e0r/HVDP_GXJ/IMG_20220321_161250.jpg

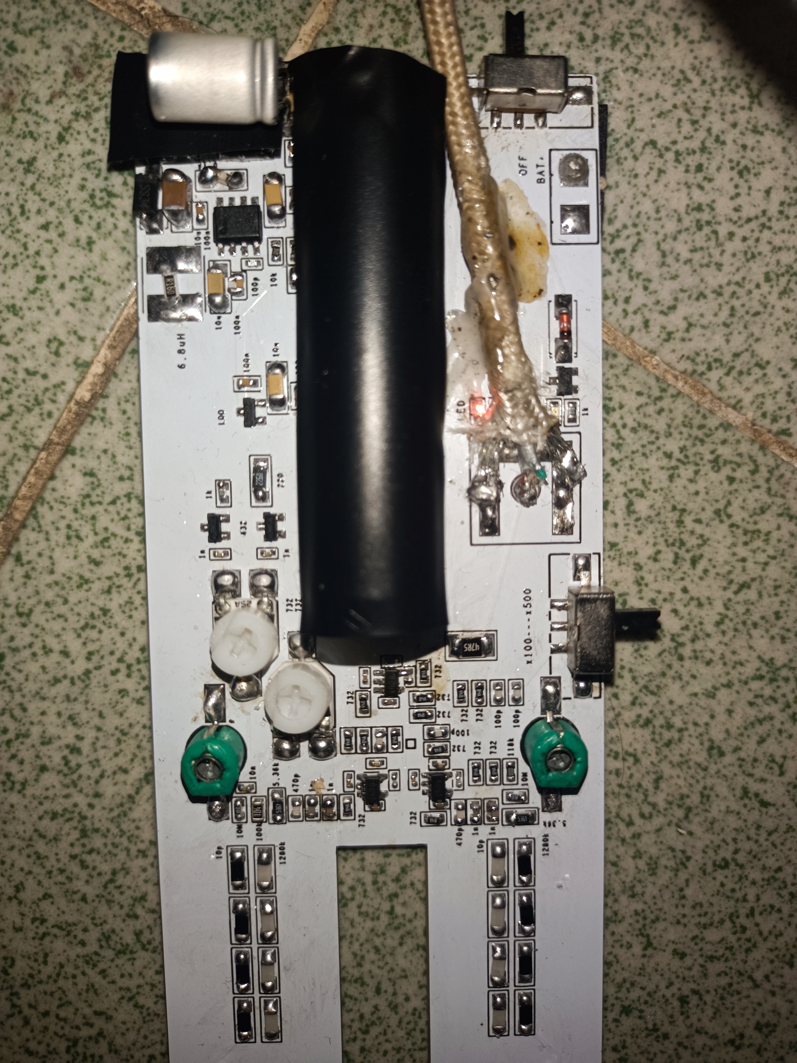
IMG_20220321_161250.jpg
