e0r/HVDP_GXJ/IMG_20220321_161255.jpg

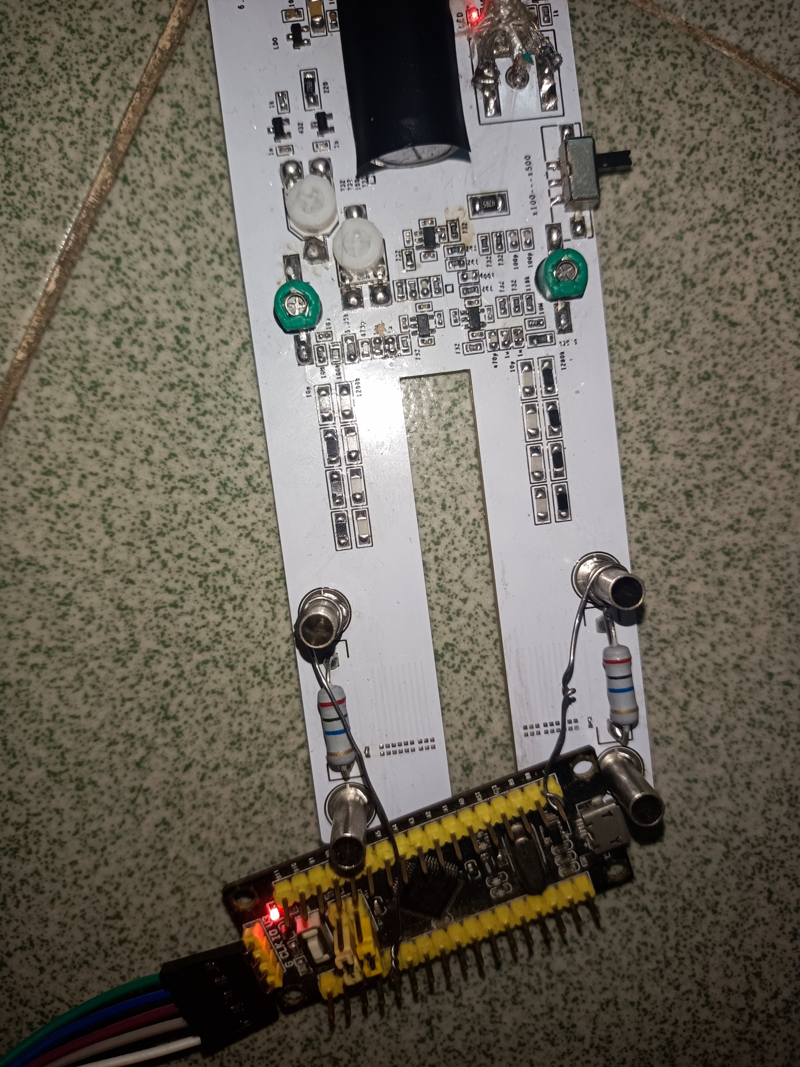
IMG_20220321_161255.jpg
