e0r/HVDP_GXJ/IMG_20220321_161343.jpg

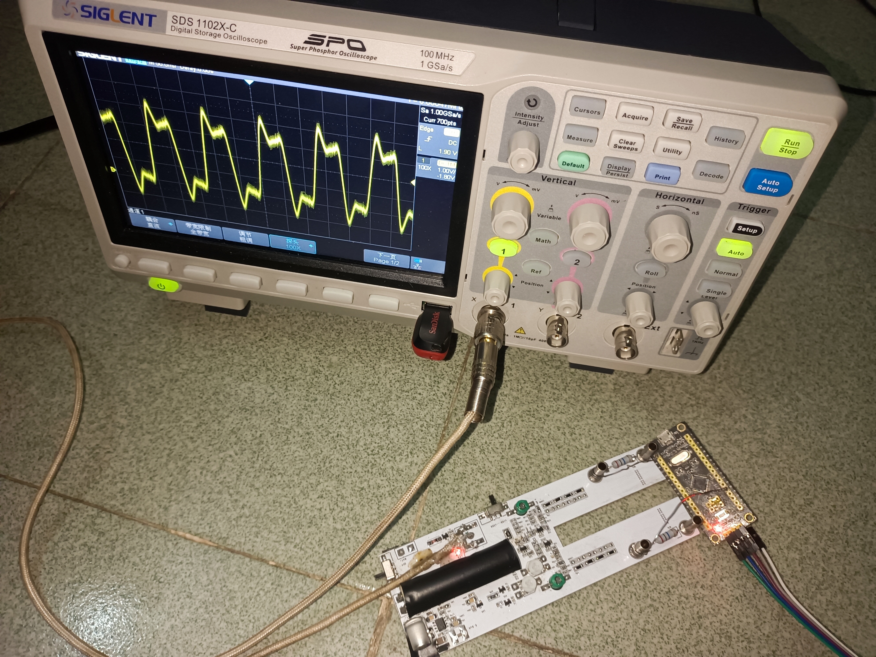
IMG_20220321_161343.jpg
