e0r/HVDP_GXJ/SDS00014.png

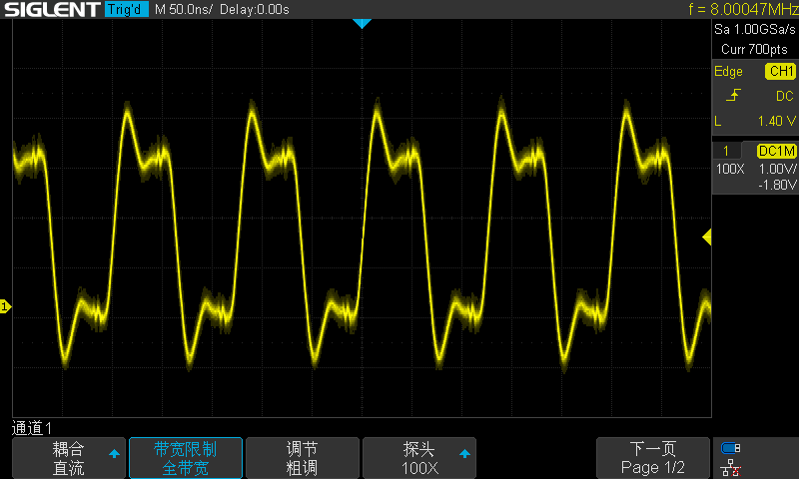
SDS00014.png
