e0r/HVDP_GXJ/SDS00015.png

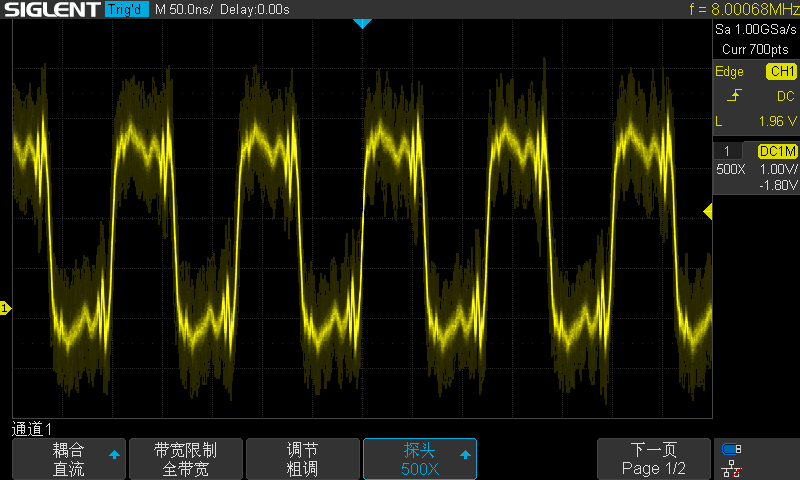
SDS00015.png
