e0r/HVDP_GXJ/BOM.xlsx

狗休紧高压差分探头 Revised: Thursday, March 10, 2022
Revision: 1
Bill Of Materials March 10,2022 21:25:46 | Page1
Item | Quantity | Reference | Part | PCB Footprint | 单价 | 小计 |  | 总价
______________________________________________ |  |  |  |  |  |  |  | 26.635282
1 | 8 | C1,C2,C3,C4,C18,C19,C20,C21 | 10p | smc1206 | 0.158471 | 1.267768
2 | 4 | C5,C6,C14,C15 | 1n | smc0603 | 0.034983 | 0.139932
3 | 2 | C7,C16 | 470p | smc0603 | 0.021969 | 0.043938
4 | 2 | C8,C13 | CAPVAR 30p | C30p | 0.42 | 0.84
5 | 4 | C9,C10,C11,C17 | 100p | smc0603 | 0.015318 | 0.061272
6 | 4 | C12,C37,C41,C45 | 10n | smc0402 | 0.008703 | 0.034812
7 | 6 | C22,C23,C24,C27,C29,C31 | 100n | smc0603 | 0.015927 | 0.095562
8 | 5 | C25,C28,C30,C32,C47 | 10u | smc1206 | 0.151539 | 0.757695
9 | 4 | C26,C36,C39,C43 | 100p | smc0402 | 0.0067 | 0.0268
10 | 5 | C33,C34,C35,C40,C44 | 1n | smc0402 | 0.005639 | 0.028195
11 | 3 | C38,C42,C46 | 100n | smc0402 | 0.004776 | 0.014328
12 | 2 | D2,D3 | SS34 | SS34 | 0.263911 | 0.527822
13 | 2 | D4,D5 | LED | smled0603 | 0.148861 | 0.297722
14 | 3 | L1,L2,L3 | 6.8uH | L6_8uh | 0.425019 | 1.275057
15 | 8 | R1,R2,R3,R4,R23,R24,R25,R26 | 1280k | smr1206 | 0.528086 | 4.224688
16 | 14 | R5,R6,R7,R10,R12,R13,R14,R17,R18,R19,R20,R21,R28,R29 | 732 | smr0603 | 0.173778 | 2.432892
17 | 2 | R8,R15 | 5.36k | smr0805 | 0.316091 | 0.632182
18 | 1 | R9 | 118k | smr0603 | 0.224418 | 0.224418
19 | 2 | R11,R22 | 10M | smr0603 | 0.007246 | 0.014492
20 | 2 | R16,R27 | 200k | R200k | 0.475236 | 0.950472
21 | 1 | R30 | 100k | smr0603 | 0.006813 | 0.006813
22 | 2 | R31,R39 | 1k | smr0603 | 0.007093 | 0.014186
23 | 1 | R32 | 0.16 | smr1206 | 0.045733 | 0.045733
24 | 4 | R33,R34,R35,R41 | 10k | smr0603 | 0.007107 | 0.028428
25 | 1 | R36 | 220 | smr1206 | 0.026209 | 0.026209
26 | 2 | R37,R38 | 20M | R20M | 0.412229 | 0.824458
27 | 1 | R40 | 47.5 | smr1210 | 0.05825 | 0.05825
28 | 20 | R42,R43,R44,R45,R46,R47,R48,R49,R50,R51,R52,R53,R54,R55,R56,R57,R58,R59,R60,R61 | 0 | nosilk0402 | 0 | 0 | DNP
29 | 2 | SW5,SW6 | gxj_sw | GXJ_SW | 0.116606 | 0.233212
30 | 3 | U1,U2,U3 | GS8091 | SOT23-5P95_280X115L45X40N | 1.6827 | 5.0481
31 | 1 | U5,U18 | LIBAT | batt | 3 | 3
32 | 1 | U8 | LP3986 | smsot23123 | 0.306432 | 0.306432
33 | 2 | U9,U10 | TL432 | smsot23132 | 0.386614 | 0.773228
34 | 1 | U11 | VDA3010NTA | smsot23123 | 0.275386 | 0.275386
35 | 4 | U12,U13,U15,U16 | input | input | 0 | 0 | 拆机端子
36 | 1 | U14 | out | qqq | 0.59 | 0.59
37 | 1 | U17 | AZ34063 | soic8 | 1.5148 | 1.5148
