e0r/HVDP_GXJ/DraftHVDP8091.asc

C1: cap; 2.5p
C2: cap; 2.5p
C3: cap; 100p
C4: cap; 100p
C5: cap; 100p
C6: cap; 100p
C7: cap; 200p
C8: cap; 200p
C9: cap; 200p
C10: cap; 13p
C11: cap; 2470p
C12: cap; 2470p
C13: cap; 50p
C14: cap; 50p
L1: ind; 1.5µ
L2: ind; 1.5µ
R1: res; 2k
R2: res; 5120k
R3: res; 2k
R4: res; 5120k
R5: res; 732
R6: res; 732
R7: res; 732
R8: res; 732
R9: res; 366
R10: res; 366
R11: res; 366
R12: res; 47.5
R13: res; 1Meg
R14: res; 732
R15: res; 732
R16: res; 5125.1685
R17: res; 5125.1685
R18: res; 100
R19: res; 100
R20: res; 2.5
R21: res; 2.5
U1: AD8091
U2: AD8091
U3: AD8091
V1: voltage; +3.3
V2: voltage; -1.8
V3: voltage; SINE(0 1); AC 1 0
V4: voltage; SINE(0 1); AC 1 180
Named nets: 0, V+, V-, INN+, INN-, OUT
.ac dec 10000 1k 100MEG
SW
;.step param RR 1 5 0.5
